kevinawalsh/metro485/daemon/README.md

The daemon must be running for MaxMSP to communicate with the Arduino board.

Compile using command:
  make clean all

Run using command:
  ./global-metro
