kevinawalsh/metro485/metro485.jpg

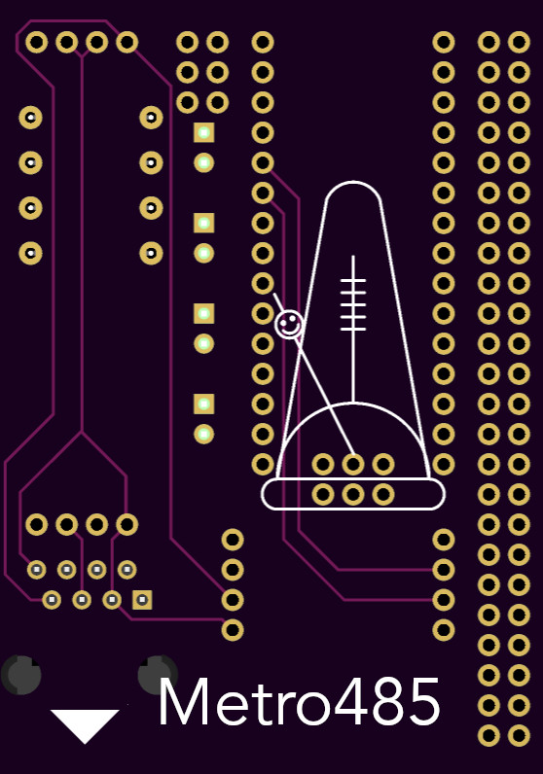
metro485.jpg
