kevinawalsh/metro485/(commit log)

2023-09-25 fix bugs in warning, add start script
    [debug.c, main.c, main.h, metro_conductor.ino, metro_remote.ino, osc.c, str.c, udp.c]
2024-08-25 Power fixes
    Conductor now uses external regulated power supply for all rs485
    transceivers and to power the arduino nano (through the 5v pin) and
    other components, rather than drawing power through arduino nano 5v pin.
    Also added capacitors to hardware to cope with large power draw when
    transceivers are active.
    Conductor arduino now wired and programmed to disable rs485 tx
    transceivers, using DE pin on max485 modules, when not transmitting.
    [metro_conductor.ino]
